abishekparajuli-np/FireFightingRobotWithObstacleDetection/circuit.png

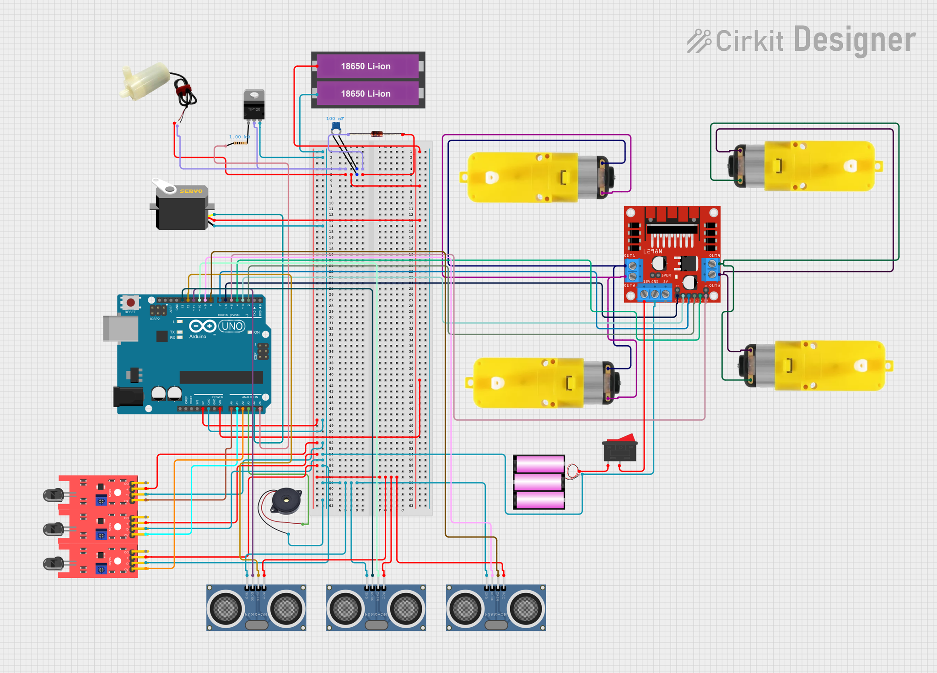
circuit.png
